bradyquelet/Automatic-Blinds-Project/README.md

# Automatic Blinds Project

Arduino-based mechatronics project that automates window blinds and room lighting using a photoresistor, PIR motion sensor, DC motor, L293D H-bridge, and addressable LED strip. Project was constrained to 3 weeks class time and a $100 budget.

## Overview
This system uses ambient light levels to raise or lower blinds and uses motion detection to turn on LEDs when the blinds are closed and the room is occupied.

## My Contributions
- Designed the Arduino housing in SolidWorks
- Created electrical schematics and aided in system integration
- Contributed to Arduino programming for sensor input, motor control, and LED operation

## Tools & Components
- Arduino Uno
- Photoresistor
- PIR motion sensor
- L293D H-bridge
- DC motor
- WS2812B LED strip
- SolidWorks
- TinkerCAD

## Repository Contents
- `/code` — Arduino control code
- `/images` — CAD, schematic, workflow, and prototype images
- `/docs` — final project report and BOM
