bradyquelet/Automatic-Blinds-Project/images/MechFlowChart.png

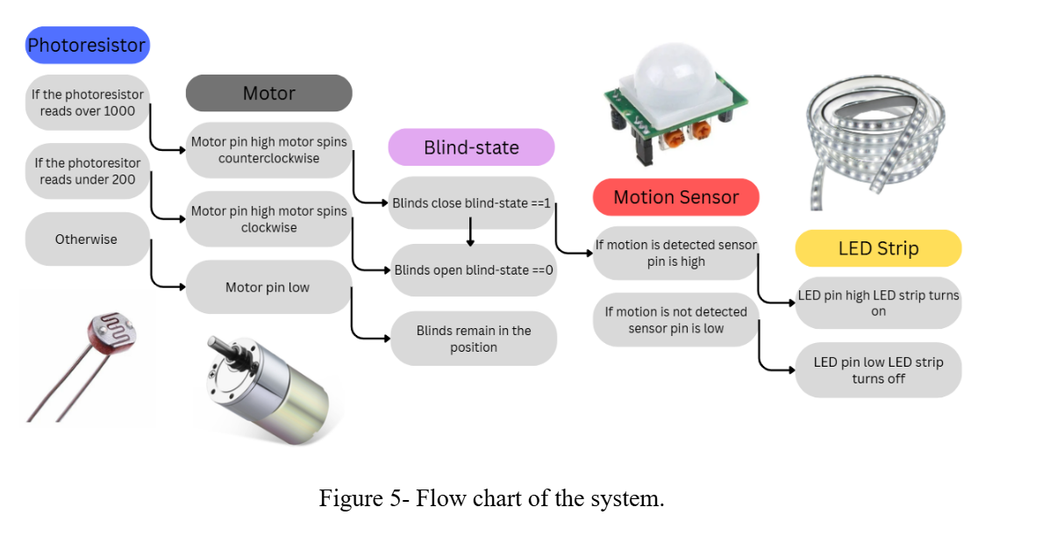
images/MechFlowChart.png
