bradyquelet/Automatic-Blinds-Project/images/MechTinkerCAD.png

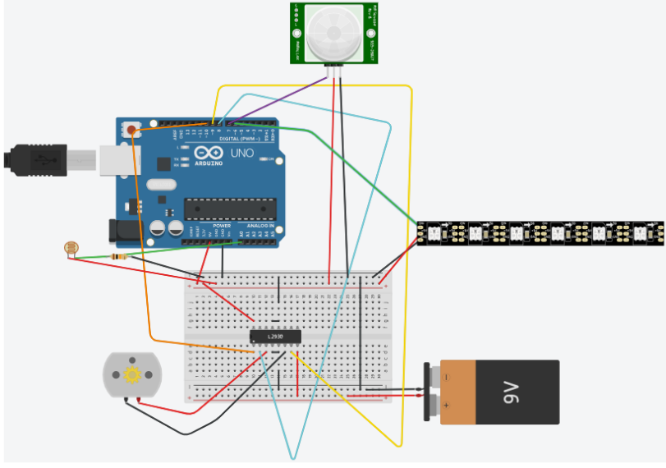
images/MechTinkerCAD.png
