bradyquelet/Automatic-Blinds-Project/images/simplifiedElectricalDrawingMech.png

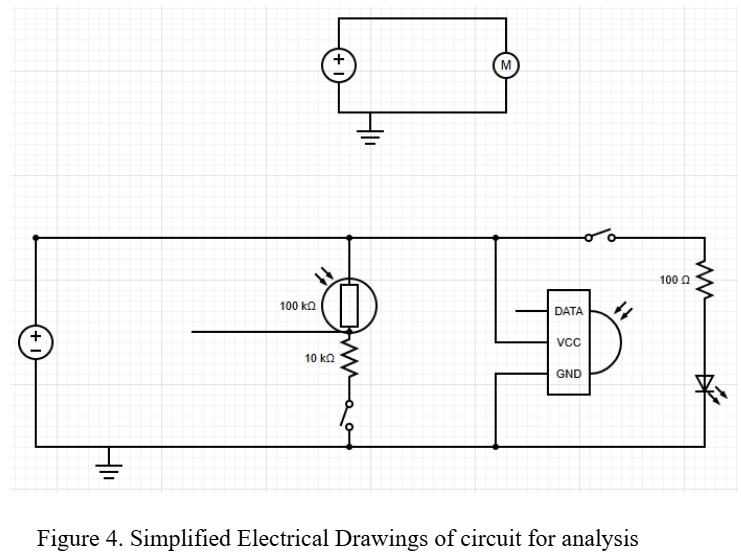
images/simplifiedElectricalDrawingMech.png
