bradyquelet/Automatic-Blinds-Project/docs/autoBlindsBOM.png

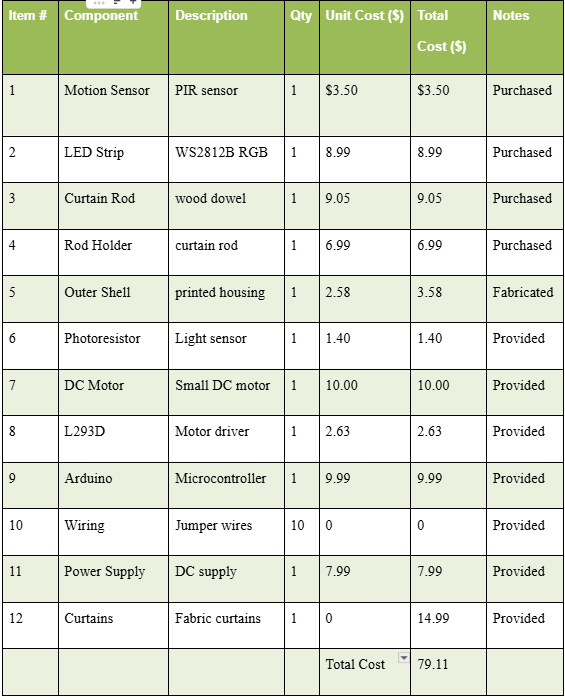
docs/autoBlindsBOM.png
