bradyquelet/Automatic-Blinds-Project/images/MechSWassembly.png

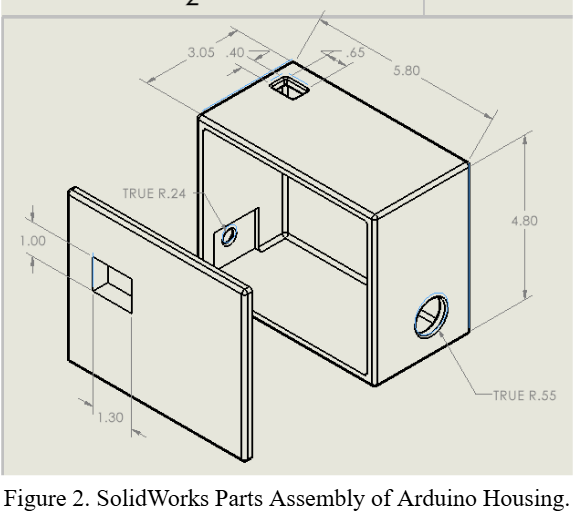
images/MechSWassembly.png
